FondazioneChipsIT/astral/README.md

# SCAR-V

**SCAR-V** (**S**uperscalar **C**FI **A**ccelerated **R**ISC **-V** Processor) is developed by Fondazione Chips-IT as a fully open-source framework that exploits the RoT to implement runtime-adaptable machine learning-based CFI enforcement in heterogeneous RISC-V SoCs.
SCAR-V integrates a zero-overhead Control-Transfer Record Unit in the application
core exposing the execution traces to a trace snooper; secure orchestration within the OpenTitan Root of Trust; low-latency AI-based CFI anomaly detection deployed on an 8-core cluster executing in a secure environment within the RoT perimeter.

SCAR-V is implemented on a reference architecture from [Pulp-Platform](https://github.com/pulp-platform) that features [OpenTitan](https://opentitan.org/) as embedded RoT and synthesized the system in Global Foundries 22 nm FD-SOI process.

For a detailed description of the CFI theory and architecture see: (TODO) add link to paper by M. Ciani et alt.

## Motivation

Modern embedded systems, such as IoT devices and safety-critical cyber-physical platforms deployed in the field,
are exposed to control-flow hijacking attacks, where techniques like Return-Oriented Programming and Jump-Oriented Programming can bypass safety checks and compromise system integrity. Control-Flow Integrity has long been recognized as a
security countermeasure. However, existing solutions either rely on pure-software mechanisms incurring high latency overheads, or hardware solutions which are either based on fixed hardware monitors that prevents runtime adapatbility, or on proprietary ISA extensions and compiling toolchains, limiting flexibility.
Moreover, most of existing solutions are not anchored to a hardware Root-of-Trust (RoT).

## Quick Start

* To learn how to build and use SCAR-V, see [Getting
  Started](https://fondazionechipsit.github.io/astral/gs/).
* To learn about available simulation, FPGA, and ASIC targets, see
  [Targets](https://fondazionechipsit.github.io/astral/tg).
* For detailed information on SCAR-V's inner workings, consult the [User
  Manual](https://fondazionechipsit.github.io/astral/um/).

If you are impatient and have all needed
[dependencies](https://fondazionechipsit.github.io/astral/gs/#dependencies), type:

```
source env/env-chips.sh
bender update
make car-all PYTHON=python3
make tech-init
```

and then run a [simulation](https://fondazionechipsit.github.io/astral/tg/sim) with Questasim by typing:

```tcl
make car-vsim-sim-build DEBUG=1 TECH_SIM=1
make car-vsim-sim-run CHS_BINARY=./sw/tests/bare-metal/hostd/helloworld.car.spm.elf DEBUG=1 TECH_SIM=1
```

---

To display the main *Make* build targets and their usage, from the root repository type:

```tcl
make help
```

The Make files are autodocumented.

### Technology

It is possible to initialize an available technology design flow by running `make tech-init` after cloning the repo.

## License

Unless specified otherwise in the respective file headers, all code checked into this repository is
made available under a permissive license. All hardware sources and tool scripts are licensed under
the Solderpad Hardware License 0.51 (see `LICENSE`) with the exception of generated register file
code (e.g. `hw/regs/*.sv`), which is generated by a fork of lowRISC's
[`regtool`](https://github.com/lowRISC/opentitan/blob/master/util/regtool.py) and licensed under
Apache 2.0. All software sources are licensed under Apache 2.0.
