FondazioneChipsIT/astral/docs/tg/synth.md

# Logic synthesis and physical implementation

Currently, synthesis of SCAAR-V is available with closed source tools, and hence its scripts are
added in the `nonfree` repository mentioned in the [Getting Started](../gs.md) section.

Once open-EDA and open-PDK flow is available, it will be updated in this page.
