FondazioneChipsIT/astral/sw/include/regs/soc_ctrl.h

// Generated register defines for carfield

// Copyright information found in source file:
// Copyright 2023 ETH Zurich and University of Bologna.

// Licensing information found in source file:
// 
// SPDX-License-Identifier: SHL-0.51

#ifndef _CARFIELD_REG_DEFS_
#define _CARFIELD_REG_DEFS_

#ifdef __cplusplus
extern "C" {
#endif
// Register width
#define CARFIELD_PARAM_REG_WIDTH 32

// Cheshire sha256 commit
#define CARFIELD_VERSION0_REG_OFFSET 0x0

// Safety Island sha256 commit
#define CARFIELD_VERSION1_REG_OFFSET 0x4

// Security Island sha256 commit
#define CARFIELD_VERSION2_REG_OFFSET 0x8

// PULP Cluster sha256 commit
#define CARFIELD_VERSION3_REG_OFFSET 0xc

// Spatz CLuster sha256 commit
#define CARFIELD_VERSION4_REG_OFFSET 0x10

// JEDEC ID CODE -TODO assign-
#define CARFIELD_JEDEC_IDCODE_REG_OFFSET 0x14

// Scratch
#define CARFIELD_GENERIC_SCRATCH0_REG_OFFSET 0x18

// Scratch
#define CARFIELD_GENERIC_SCRATCH1_REG_OFFSET 0x1c

// Host Domain reset -active high, inverted in HW-
#define CARFIELD_HOST_RST_REG_OFFSET 0x20
#define CARFIELD_HOST_RST_HOST_RST_BIT 0

// Periph Domain reset -active high, inverted in HW-
#define CARFIELD_PERIPH_RST_REG_OFFSET 0x24
#define CARFIELD_PERIPH_RST_PERIPH_RST_BIT 0

// Safety Island reset -active high, inverted in HW-
#define CARFIELD_SAFETY_ISLAND_RST_REG_OFFSET 0x28
#define CARFIELD_SAFETY_ISLAND_RST_SAFETY_ISLAND_RST_BIT 0

// Security Island reset -active high, inverted in HW-
#define CARFIELD_SECURITY_ISLAND_RST_REG_OFFSET 0x2c
#define CARFIELD_SECURITY_ISLAND_RST_SECURITY_ISLAND_RST_BIT 0

// PULP Cluster reset -active high, inverted in HW-
#define CARFIELD_PULP_CLUSTER_RST_REG_OFFSET 0x30
#define CARFIELD_PULP_CLUSTER_RST_PULP_CLUSTER_RST_BIT 0

// Spatz Cluster reset -active high, inverted in HW-
#define CARFIELD_SPATZ_CLUSTER_RST_REG_OFFSET 0x34
#define CARFIELD_SPATZ_CLUSTER_RST_SPATZ_CLUSTER_RST_BIT 0

// L2 reset -active high, inverted in HW-
#define CARFIELD_L2_RST_REG_OFFSET 0x38
#define CARFIELD_L2_RST_L2_RST_BIT 0

// Periph Domain  AXI isolate
#define CARFIELD_PERIPH_ISOLATE_REG_OFFSET 0x3c
#define CARFIELD_PERIPH_ISOLATE_PERIPH_ISOLATE_BIT 0

// Safety Island AXI isolate
#define CARFIELD_SAFETY_ISLAND_ISOLATE_REG_OFFSET 0x40
#define CARFIELD_SAFETY_ISLAND_ISOLATE_SAFETY_ISLAND_ISOLATE_BIT 0

// Security Island AXI isolate
#define CARFIELD_SECURITY_ISLAND_ISOLATE_REG_OFFSET 0x44
#define CARFIELD_SECURITY_ISLAND_ISOLATE_SECURITY_ISLAND_ISOLATE_BIT 0

// PULP Cluster AXI isolate
#define CARFIELD_PULP_CLUSTER_ISOLATE_REG_OFFSET 0x48
#define CARFIELD_PULP_CLUSTER_ISOLATE_PULP_CLUSTER_ISOLATE_BIT 0

// Spatz Cluster AXI isolate
#define CARFIELD_SPATZ_CLUSTER_ISOLATE_REG_OFFSET 0x4c
#define CARFIELD_SPATZ_CLUSTER_ISOLATE_SPATZ_CLUSTER_ISOLATE_BIT 0

// L2 AXI isolate
#define CARFIELD_L2_ISOLATE_REG_OFFSET 0x50
#define CARFIELD_L2_ISOLATE_L2_ISOLATE_BIT 0

// Periph Domain AXI isolate status
#define CARFIELD_PERIPH_ISOLATE_STATUS_REG_OFFSET 0x54
#define CARFIELD_PERIPH_ISOLATE_STATUS_PERIPH_ISOLATE_STATUS_BIT 0

// Safety Island AXI isolate status
#define CARFIELD_SAFETY_ISLAND_ISOLATE_STATUS_REG_OFFSET 0x58
#define CARFIELD_SAFETY_ISLAND_ISOLATE_STATUS_SAFETY_ISLAND_ISOLATE_STATUS_BIT 0

// Security Island AXI isolate status
#define CARFIELD_SECURITY_ISLAND_ISOLATE_STATUS_REG_OFFSET 0x5c
#define CARFIELD_SECURITY_ISLAND_ISOLATE_STATUS_SECURITY_ISLAND_ISOLATE_STATUS_BIT \
  0

// PULP Cluster AXI isolate status
#define CARFIELD_PULP_CLUSTER_ISOLATE_STATUS_REG_OFFSET 0x60
#define CARFIELD_PULP_CLUSTER_ISOLATE_STATUS_PULP_CLUSTER_ISOLATE_STATUS_BIT 0

// Spatz Cluster AXI isolate status
#define CARFIELD_SPATZ_CLUSTER_ISOLATE_STATUS_REG_OFFSET 0x64
#define CARFIELD_SPATZ_CLUSTER_ISOLATE_STATUS_SPATZ_CLUSTER_ISOLATE_STATUS_BIT 0

// L2 AXI isolate status
#define CARFIELD_L2_ISOLATE_STATUS_REG_OFFSET 0x68
#define CARFIELD_L2_ISOLATE_STATUS_L2_ISOLATE_STATUS_BIT 0

// Periph Domain clk gate enable
#define CARFIELD_PERIPH_CLK_EN_REG_OFFSET 0x6c
#define CARFIELD_PERIPH_CLK_EN_PERIPH_CLK_EN_BIT 0

// Safety Island clk gate enable
#define CARFIELD_SAFETY_ISLAND_CLK_EN_REG_OFFSET 0x70
#define CARFIELD_SAFETY_ISLAND_CLK_EN_SAFETY_ISLAND_CLK_EN_BIT 0

// Security Island clk gate enable
#define CARFIELD_SECURITY_ISLAND_CLK_EN_REG_OFFSET 0x74
#define CARFIELD_SECURITY_ISLAND_CLK_EN_SECURITY_ISLAND_CLK_EN_BIT 0

// PULP Cluster clk gate enable
#define CARFIELD_PULP_CLUSTER_CLK_EN_REG_OFFSET 0x78
#define CARFIELD_PULP_CLUSTER_CLK_EN_PULP_CLUSTER_CLK_EN_BIT 0

// Spatz Cluster clk gate enable
#define CARFIELD_SPATZ_CLUSTER_CLK_EN_REG_OFFSET 0x7c
#define CARFIELD_SPATZ_CLUSTER_CLK_EN_SPATZ_CLUSTER_CLK_EN_BIT 0

// Shared L2 memory clk gate enable
#define CARFIELD_L2_CLK_EN_REG_OFFSET 0x80
#define CARFIELD_L2_CLK_EN_L2_CLK_EN_BIT 0

// Periph Domain fll select (0 -> host fll, 1 -> alt fll, 2 -> per fll, 3 ->
// secd fll)
#define CARFIELD_PERIPH_CLK_SEL_REG_OFFSET 0x84
#define CARFIELD_PERIPH_CLK_SEL_PERIPH_CLK_SEL_MASK 0x3
#define CARFIELD_PERIPH_CLK_SEL_PERIPH_CLK_SEL_OFFSET 0
#define CARFIELD_PERIPH_CLK_SEL_PERIPH_CLK_SEL_FIELD \
  ((bitfield_field32_t) { .mask = CARFIELD_PERIPH_CLK_SEL_PERIPH_CLK_SEL_MASK, .index = CARFIELD_PERIPH_CLK_SEL_PERIPH_CLK_SEL_OFFSET })

// Safety Island fll select (0 -> host fll, 1 -> alt fll, 2 -> per fll, 3 ->
// secd fll)
#define CARFIELD_SAFETY_ISLAND_CLK_SEL_REG_OFFSET 0x88
#define CARFIELD_SAFETY_ISLAND_CLK_SEL_SAFETY_ISLAND_CLK_SEL_MASK 0x3
#define CARFIELD_SAFETY_ISLAND_CLK_SEL_SAFETY_ISLAND_CLK_SEL_OFFSET 0
#define CARFIELD_SAFETY_ISLAND_CLK_SEL_SAFETY_ISLAND_CLK_SEL_FIELD \
  ((bitfield_field32_t) { .mask = CARFIELD_SAFETY_ISLAND_CLK_SEL_SAFETY_ISLAND_CLK_SEL_MASK, .index = CARFIELD_SAFETY_ISLAND_CLK_SEL_SAFETY_ISLAND_CLK_SEL_OFFSET })

// Security Island fll select (0 -> host fll, 1 -> alt fll, 2 -> per fll, 3
// -> secd fll)
#define CARFIELD_SECURITY_ISLAND_CLK_SEL_REG_OFFSET 0x8c
#define CARFIELD_SECURITY_ISLAND_CLK_SEL_SECURITY_ISLAND_CLK_SEL_MASK 0x3
#define CARFIELD_SECURITY_ISLAND_CLK_SEL_SECURITY_ISLAND_CLK_SEL_OFFSET 0
#define CARFIELD_SECURITY_ISLAND_CLK_SEL_SECURITY_ISLAND_CLK_SEL_FIELD \
  ((bitfield_field32_t) { .mask = CARFIELD_SECURITY_ISLAND_CLK_SEL_SECURITY_ISLAND_CLK_SEL_MASK, .index = CARFIELD_SECURITY_ISLAND_CLK_SEL_SECURITY_ISLAND_CLK_SEL_OFFSET })

// PULP Cluster fll select (0 -> host fll, 1 -> alt fll, 2 -> per fll, 3 ->
// secd fll)
#define CARFIELD_PULP_CLUSTER_CLK_SEL_REG_OFFSET 0x90
#define CARFIELD_PULP_CLUSTER_CLK_SEL_PULP_CLUSTER_CLK_SEL_MASK 0x3
#define CARFIELD_PULP_CLUSTER_CLK_SEL_PULP_CLUSTER_CLK_SEL_OFFSET 0
#define CARFIELD_PULP_CLUSTER_CLK_SEL_PULP_CLUSTER_CLK_SEL_FIELD \
  ((bitfield_field32_t) { .mask = CARFIELD_PULP_CLUSTER_CLK_SEL_PULP_CLUSTER_CLK_SEL_MASK, .index = CARFIELD_PULP_CLUSTER_CLK_SEL_PULP_CLUSTER_CLK_SEL_OFFSET })

// Spatz Cluster fll select (0 -> host fll, 1 -> alt fll, 2 -> per fll, 3 ->
// secd fll)
#define CARFIELD_SPATZ_CLUSTER_CLK_SEL_REG_OFFSET 0x94
#define CARFIELD_SPATZ_CLUSTER_CLK_SEL_SPATZ_CLUSTER_CLK_SEL_MASK 0x3
#define CARFIELD_SPATZ_CLUSTER_CLK_SEL_SPATZ_CLUSTER_CLK_SEL_OFFSET 0
#define CARFIELD_SPATZ_CLUSTER_CLK_SEL_SPATZ_CLUSTER_CLK_SEL_FIELD \
  ((bitfield_field32_t) { .mask = CARFIELD_SPATZ_CLUSTER_CLK_SEL_SPATZ_CLUSTER_CLK_SEL_MASK, .index = CARFIELD_SPATZ_CLUSTER_CLK_SEL_SPATZ_CLUSTER_CLK_SEL_OFFSET })

// L2 Memory fll select (0 -> host fll, 1 -> alt fll, 2 -> per fll, 3 -> secd
// fll)
#define CARFIELD_L2_CLK_SEL_REG_OFFSET 0x98
#define CARFIELD_L2_CLK_SEL_L2_CLK_SEL_MASK 0x3
#define CARFIELD_L2_CLK_SEL_L2_CLK_SEL_OFFSET 0
#define CARFIELD_L2_CLK_SEL_L2_CLK_SEL_FIELD \
  ((bitfield_field32_t) { .mask = CARFIELD_L2_CLK_SEL_L2_CLK_SEL_MASK, .index = CARFIELD_L2_CLK_SEL_L2_CLK_SEL_OFFSET })

// Periph Domain clk divider value
#define CARFIELD_PERIPH_CLK_DIV_VALUE_REG_OFFSET 0x9c
#define CARFIELD_PERIPH_CLK_DIV_VALUE_PERIPH_CLK_DIV_VALUE_MASK 0xffffff
#define CARFIELD_PERIPH_CLK_DIV_VALUE_PERIPH_CLK_DIV_VALUE_OFFSET 0
#define CARFIELD_PERIPH_CLK_DIV_VALUE_PERIPH_CLK_DIV_VALUE_FIELD \
  ((bitfield_field32_t) { .mask = CARFIELD_PERIPH_CLK_DIV_VALUE_PERIPH_CLK_DIV_VALUE_MASK, .index = CARFIELD_PERIPH_CLK_DIV_VALUE_PERIPH_CLK_DIV_VALUE_OFFSET })

// Safety Island clk divider value
#define CARFIELD_SAFETY_ISLAND_CLK_DIV_VALUE_REG_OFFSET 0xa0
#define CARFIELD_SAFETY_ISLAND_CLK_DIV_VALUE_SAFETY_ISLAND_CLK_DIV_VALUE_MASK \
  0xffffff
#define CARFIELD_SAFETY_ISLAND_CLK_DIV_VALUE_SAFETY_ISLAND_CLK_DIV_VALUE_OFFSET \
  0
#define CARFIELD_SAFETY_ISLAND_CLK_DIV_VALUE_SAFETY_ISLAND_CLK_DIV_VALUE_FIELD \
  ((bitfield_field32_t) { .mask = CARFIELD_SAFETY_ISLAND_CLK_DIV_VALUE_SAFETY_ISLAND_CLK_DIV_VALUE_MASK, .index = CARFIELD_SAFETY_ISLAND_CLK_DIV_VALUE_SAFETY_ISLAND_CLK_DIV_VALUE_OFFSET })

// Security Island clk divider value
#define CARFIELD_SECURITY_ISLAND_CLK_DIV_VALUE_REG_OFFSET 0xa4
#define CARFIELD_SECURITY_ISLAND_CLK_DIV_VALUE_SECURITY_ISLAND_CLK_DIV_VALUE_MASK \
  0xffffff
#define CARFIELD_SECURITY_ISLAND_CLK_DIV_VALUE_SECURITY_ISLAND_CLK_DIV_VALUE_OFFSET \
  0
#define CARFIELD_SECURITY_ISLAND_CLK_DIV_VALUE_SECURITY_ISLAND_CLK_DIV_VALUE_FIELD \
  ((bitfield_field32_t) { .mask = CARFIELD_SECURITY_ISLAND_CLK_DIV_VALUE_SECURITY_ISLAND_CLK_DIV_VALUE_MASK, .index = CARFIELD_SECURITY_ISLAND_CLK_DIV_VALUE_SECURITY_ISLAND_CLK_DIV_VALUE_OFFSET })

// PULP Cluster clk divider value
#define CARFIELD_PULP_CLUSTER_CLK_DIV_VALUE_REG_OFFSET 0xa8
#define CARFIELD_PULP_CLUSTER_CLK_DIV_VALUE_PULP_CLUSTER_CLK_DIV_VALUE_MASK \
  0xffffff
#define CARFIELD_PULP_CLUSTER_CLK_DIV_VALUE_PULP_CLUSTER_CLK_DIV_VALUE_OFFSET 0
#define CARFIELD_PULP_CLUSTER_CLK_DIV_VALUE_PULP_CLUSTER_CLK_DIV_VALUE_FIELD \
  ((bitfield_field32_t) { .mask = CARFIELD_PULP_CLUSTER_CLK_DIV_VALUE_PULP_CLUSTER_CLK_DIV_VALUE_MASK, .index = CARFIELD_PULP_CLUSTER_CLK_DIV_VALUE_PULP_CLUSTER_CLK_DIV_VALUE_OFFSET })

// Spatz Cluster clk divider value
#define CARFIELD_SPATZ_CLUSTER_CLK_DIV_VALUE_REG_OFFSET 0xac
#define CARFIELD_SPATZ_CLUSTER_CLK_DIV_VALUE_SPATZ_CLUSTER_CLK_DIV_VALUE_MASK \
  0xffffff
#define CARFIELD_SPATZ_CLUSTER_CLK_DIV_VALUE_SPATZ_CLUSTER_CLK_DIV_VALUE_OFFSET \
  0
#define CARFIELD_SPATZ_CLUSTER_CLK_DIV_VALUE_SPATZ_CLUSTER_CLK_DIV_VALUE_FIELD \
  ((bitfield_field32_t) { .mask = CARFIELD_SPATZ_CLUSTER_CLK_DIV_VALUE_SPATZ_CLUSTER_CLK_DIV_VALUE_MASK, .index = CARFIELD_SPATZ_CLUSTER_CLK_DIV_VALUE_SPATZ_CLUSTER_CLK_DIV_VALUE_OFFSET })

// L2 Memory clk divider value
#define CARFIELD_L2_CLK_DIV_VALUE_REG_OFFSET 0xb0
#define CARFIELD_L2_CLK_DIV_VALUE_L2_CLK_DIV_VALUE_MASK 0xffffff
#define CARFIELD_L2_CLK_DIV_VALUE_L2_CLK_DIV_VALUE_OFFSET 0
#define CARFIELD_L2_CLK_DIV_VALUE_L2_CLK_DIV_VALUE_FIELD \
  ((bitfield_field32_t) { .mask = CARFIELD_L2_CLK_DIV_VALUE_L2_CLK_DIV_VALUE_MASK, .index = CARFIELD_L2_CLK_DIV_VALUE_L2_CLK_DIV_VALUE_OFFSET })

// Host Domain fetch enable
#define CARFIELD_HOST_FETCH_ENABLE_REG_OFFSET 0xb4
#define CARFIELD_HOST_FETCH_ENABLE_HOST_FETCH_ENABLE_BIT 0

// Safety Island fetch enable
#define CARFIELD_SAFETY_ISLAND_FETCH_ENABLE_REG_OFFSET 0xb8
#define CARFIELD_SAFETY_ISLAND_FETCH_ENABLE_SAFETY_ISLAND_FETCH_ENABLE_BIT 0

// Security Island fetch enable
#define CARFIELD_SECURITY_ISLAND_FETCH_ENABLE_REG_OFFSET 0xbc
#define CARFIELD_SECURITY_ISLAND_FETCH_ENABLE_SECURITY_ISLAND_FETCH_ENABLE_BIT 0

// PULP Cluster fetch enable
#define CARFIELD_PULP_CLUSTER_FETCH_ENABLE_REG_OFFSET 0xc0
#define CARFIELD_PULP_CLUSTER_FETCH_ENABLE_PULP_CLUSTER_FETCH_ENABLE_BIT 0

// Spatz Cluster debug req
#define CARFIELD_SPATZ_CLUSTER_DEBUG_REQ_REG_OFFSET 0xc4
#define CARFIELD_SPATZ_CLUSTER_DEBUG_REQ_SPATZ_CLUSTER_DEBUG_REQ_MASK 0x3
#define CARFIELD_SPATZ_CLUSTER_DEBUG_REQ_SPATZ_CLUSTER_DEBUG_REQ_OFFSET 0
#define CARFIELD_SPATZ_CLUSTER_DEBUG_REQ_SPATZ_CLUSTER_DEBUG_REQ_FIELD \
  ((bitfield_field32_t) { .mask = CARFIELD_SPATZ_CLUSTER_DEBUG_REQ_SPATZ_CLUSTER_DEBUG_REQ_MASK, .index = CARFIELD_SPATZ_CLUSTER_DEBUG_REQ_SPATZ_CLUSTER_DEBUG_REQ_OFFSET })

// Host boot address
#define CARFIELD_HOST_BOOT_ADDR_REG_OFFSET 0xc8

// Safety Island boot address
#define CARFIELD_SAFETY_ISLAND_BOOT_ADDR_REG_OFFSET 0xcc

// Security Island boot address
#define CARFIELD_SECURITY_ISLAND_BOOT_ADDR_REG_OFFSET 0xd0

// PULP Cluster boot address
#define CARFIELD_PULP_CLUSTER_BOOT_ADDR_REG_OFFSET 0xd4

// Spatz Cluster boot address
#define CARFIELD_SPATZ_CLUSTER_BOOT_ADDR_REG_OFFSET 0xd8

// PULP Cluster boot enable
#define CARFIELD_PULP_CLUSTER_BOOT_ENABLE_REG_OFFSET 0xdc
#define CARFIELD_PULP_CLUSTER_BOOT_ENABLE_PULP_CLUSTER_BOOT_ENABLE_BIT 0

// Spatz Cluster busy
#define CARFIELD_SPATZ_CLUSTER_BUSY_REG_OFFSET 0xe0
#define CARFIELD_SPATZ_CLUSTER_BUSY_SPATZ_CLUSTER_BUSY_BIT 0

// PULP Cluster busy
#define CARFIELD_PULP_CLUSTER_BUSY_REG_OFFSET 0xe4
#define CARFIELD_PULP_CLUSTER_BUSY_PULP_CLUSTER_BUSY_BIT 0

// PULP Cluster end of computation
#define CARFIELD_PULP_CLUSTER_EOC_REG_OFFSET 0xe8
#define CARFIELD_PULP_CLUSTER_EOC_PULP_CLUSTER_EOC_BIT 0

// Ethernet clock divider enable bit
#define CARFIELD_ETH_CLK_DIV_EN_REG_OFFSET 0xec
#define CARFIELD_ETH_CLK_DIV_EN_ETH_CLK_DIV_EN_BIT 0

// Ethernet clock divider value
#define CARFIELD_ETH_CLK_DIV_VALUE_REG_OFFSET 0xf0
#define CARFIELD_ETH_CLK_DIV_VALUE_ETH_CLK_DIV_VALUE_MASK 0xfffff
#define CARFIELD_ETH_CLK_DIV_VALUE_ETH_CLK_DIV_VALUE_OFFSET 0
#define CARFIELD_ETH_CLK_DIV_VALUE_ETH_CLK_DIV_VALUE_FIELD \
  ((bitfield_field32_t) { .mask = CARFIELD_ETH_CLK_DIV_VALUE_ETH_CLK_DIV_VALUE_MASK, .index = CARFIELD_ETH_CLK_DIV_VALUE_ETH_CLK_DIV_VALUE_OFFSET })

// Hyperbus clock divider enable bit
#define CARFIELD_HYPERBUS_CLK_DIV_EN_REG_OFFSET 0xf4
#define CARFIELD_HYPERBUS_CLK_DIV_EN_HYPERBUS_CLK_DIV_EN_BIT 0

// Hyperbus clock divider value
#define CARFIELD_HYPERBUS_CLK_DIV_VALUE_REG_OFFSET 0xf8
#define CARFIELD_HYPERBUS_CLK_DIV_VALUE_HYPERBUS_CLK_DIV_VALUE_MASK 0xfffff
#define CARFIELD_HYPERBUS_CLK_DIV_VALUE_HYPERBUS_CLK_DIV_VALUE_OFFSET 0
#define CARFIELD_HYPERBUS_CLK_DIV_VALUE_HYPERBUS_CLK_DIV_VALUE_FIELD \
  ((bitfield_field32_t) { .mask = CARFIELD_HYPERBUS_CLK_DIV_VALUE_HYPERBUS_CLK_DIV_VALUE_MASK, .index = CARFIELD_HYPERBUS_CLK_DIV_VALUE_HYPERBUS_CLK_DIV_VALUE_OFFSET })

// FLL lock status
#define CARFIELD_FLL_LOCK_REG_OFFSET 0xfc
#define CARFIELD_FLL_LOCK_FLL_LOCK_MASK 0x1f
#define CARFIELD_FLL_LOCK_FLL_LOCK_OFFSET 0
#define CARFIELD_FLL_LOCK_FLL_LOCK_FIELD \
  ((bitfield_field32_t) { .mask = CARFIELD_FLL_LOCK_FLL_LOCK_MASK, .index = CARFIELD_FLL_LOCK_FLL_LOCK_OFFSET })

// Host domain debug clock divider (default active)
#define CARFIELD_HOST_DEBUG_CLK_EN_REG_OFFSET 0x100
#define CARFIELD_HOST_DEBUG_CLK_EN_HOST_DEBUG_CLK_EN_BIT 0

// L2 domain debug clock divider (default active)
#define CARFIELD_L2_DEBUG_CLK_EN_REG_OFFSET 0x104
#define CARFIELD_L2_DEBUG_CLK_EN_L2_DEBUG_CLK_EN_BIT 0

// Safe domain debug clock divider (default active)
#define CARFIELD_SAFED_DEBUG_CLK_EN_REG_OFFSET 0x108
#define CARFIELD_SAFED_DEBUG_CLK_EN_SAFED_DEBUG_CLK_EN_BIT 0

// PULP domain debug clock divider (default active)
#define CARFIELD_PULPD_DEBUG_CLK_EN_REG_OFFSET 0x10c
#define CARFIELD_PULPD_DEBUG_CLK_EN_PULPD_DEBUG_CLK_EN_BIT 0

// Spatz domain debug clock divider (default active)
#define CARFIELD_SPATZD_DEBUG_CLK_EN_REG_OFFSET 0x110
#define CARFIELD_SPATZD_DEBUG_CLK_EN_SPATZD_DEBUG_CLK_EN_BIT 0

// Secure domain debug clock divider (default active)
#define CARFIELD_SECURED_DEBUG_CLK_EN_REG_OFFSET 0x114
#define CARFIELD_SECURED_DEBUG_CLK_EN_SECURED_DEBUG_CLK_EN_BIT 0

// Peripheral domain debug clock divider (default active)
#define CARFIELD_PERIPH_DEBUG_CLK_EN_REG_OFFSET 0x118
#define CARFIELD_PERIPH_DEBUG_CLK_EN_PERIPH_DEBUG_CLK_EN_BIT 0

// Host Domain debug clk divider value
#define CARFIELD_HOST_DEBUG_CLK_DIV_VALUE_REG_OFFSET 0x11c
#define CARFIELD_HOST_DEBUG_CLK_DIV_VALUE_HOST_DEBUG_CLK_DIV_VALUE_MASK 0xffffff
#define CARFIELD_HOST_DEBUG_CLK_DIV_VALUE_HOST_DEBUG_CLK_DIV_VALUE_OFFSET 0
#define CARFIELD_HOST_DEBUG_CLK_DIV_VALUE_HOST_DEBUG_CLK_DIV_VALUE_FIELD \
  ((bitfield_field32_t) { .mask = CARFIELD_HOST_DEBUG_CLK_DIV_VALUE_HOST_DEBUG_CLK_DIV_VALUE_MASK, .index = CARFIELD_HOST_DEBUG_CLK_DIV_VALUE_HOST_DEBUG_CLK_DIV_VALUE_OFFSET })

// L2 domain debug clk divider value
#define CARFIELD_L2_DEBUG_CLK_DIV_VALUE_REG_OFFSET 0x120
#define CARFIELD_L2_DEBUG_CLK_DIV_VALUE_L2_DEBUG_CLK_DIV_VALUE_MASK 0xffffff
#define CARFIELD_L2_DEBUG_CLK_DIV_VALUE_L2_DEBUG_CLK_DIV_VALUE_OFFSET 0
#define CARFIELD_L2_DEBUG_CLK_DIV_VALUE_L2_DEBUG_CLK_DIV_VALUE_FIELD \
  ((bitfield_field32_t) { .mask = CARFIELD_L2_DEBUG_CLK_DIV_VALUE_L2_DEBUG_CLK_DIV_VALUE_MASK, .index = CARFIELD_L2_DEBUG_CLK_DIV_VALUE_L2_DEBUG_CLK_DIV_VALUE_OFFSET })

// Safe Domain debug clk divider value
#define CARFIELD_SAFED_DEBUG_CLK_DIV_VALUE_REG_OFFSET 0x124
#define CARFIELD_SAFED_DEBUG_CLK_DIV_VALUE_SAFED_DEBUG_CLK_DIV_VALUE_MASK \
  0xffffff
#define CARFIELD_SAFED_DEBUG_CLK_DIV_VALUE_SAFED_DEBUG_CLK_DIV_VALUE_OFFSET 0
#define CARFIELD_SAFED_DEBUG_CLK_DIV_VALUE_SAFED_DEBUG_CLK_DIV_VALUE_FIELD \
  ((bitfield_field32_t) { .mask = CARFIELD_SAFED_DEBUG_CLK_DIV_VALUE_SAFED_DEBUG_CLK_DIV_VALUE_MASK, .index = CARFIELD_SAFED_DEBUG_CLK_DIV_VALUE_SAFED_DEBUG_CLK_DIV_VALUE_OFFSET })

// PULP Domain debug clk divider value
#define CARFIELD_PULPD_DEBUG_CLK_DIV_VALUE_REG_OFFSET 0x128
#define CARFIELD_PULPD_DEBUG_CLK_DIV_VALUE_PULPD_DEBUG_CLK_DIV_VALUE_MASK \
  0xffffff
#define CARFIELD_PULPD_DEBUG_CLK_DIV_VALUE_PULPD_DEBUG_CLK_DIV_VALUE_OFFSET 0
#define CARFIELD_PULPD_DEBUG_CLK_DIV_VALUE_PULPD_DEBUG_CLK_DIV_VALUE_FIELD \
  ((bitfield_field32_t) { .mask = CARFIELD_PULPD_DEBUG_CLK_DIV_VALUE_PULPD_DEBUG_CLK_DIV_VALUE_MASK, .index = CARFIELD_PULPD_DEBUG_CLK_DIV_VALUE_PULPD_DEBUG_CLK_DIV_VALUE_OFFSET })

// Spatz Domain debug clk divider value
#define CARFIELD_SPATZD_DEBUG_CLK_DIV_VALUE_REG_OFFSET 0x12c
#define CARFIELD_SPATZD_DEBUG_CLK_DIV_VALUE_SPATZD_DEBUG_CLK_DIV_VALUE_MASK \
  0xffffff
#define CARFIELD_SPATZD_DEBUG_CLK_DIV_VALUE_SPATZD_DEBUG_CLK_DIV_VALUE_OFFSET 0
#define CARFIELD_SPATZD_DEBUG_CLK_DIV_VALUE_SPATZD_DEBUG_CLK_DIV_VALUE_FIELD \
  ((bitfield_field32_t) { .mask = CARFIELD_SPATZD_DEBUG_CLK_DIV_VALUE_SPATZD_DEBUG_CLK_DIV_VALUE_MASK, .index = CARFIELD_SPATZD_DEBUG_CLK_DIV_VALUE_SPATZD_DEBUG_CLK_DIV_VALUE_OFFSET })

// Secure Domain debug clk divider value
#define CARFIELD_SECURED_DEBUG_CLK_DIV_VALUE_REG_OFFSET 0x130
#define CARFIELD_SECURED_DEBUG_CLK_DIV_VALUE_SECURED_DEBUG_CLK_DIV_VALUE_MASK \
  0xffffff
#define CARFIELD_SECURED_DEBUG_CLK_DIV_VALUE_SECURED_DEBUG_CLK_DIV_VALUE_OFFSET \
  0
#define CARFIELD_SECURED_DEBUG_CLK_DIV_VALUE_SECURED_DEBUG_CLK_DIV_VALUE_FIELD \
  ((bitfield_field32_t) { .mask = CARFIELD_SECURED_DEBUG_CLK_DIV_VALUE_SECURED_DEBUG_CLK_DIV_VALUE_MASK, .index = CARFIELD_SECURED_DEBUG_CLK_DIV_VALUE_SECURED_DEBUG_CLK_DIV_VALUE_OFFSET })

// Peripheral Domain debug clk divider value
#define CARFIELD_PERIPH_DEBUG_CLK_DIV_VALUE_REG_OFFSET 0x134
#define CARFIELD_PERIPH_DEBUG_CLK_DIV_VALUE_PERIPH_DEBUG_CLK_DIV_VALUE_MASK \
  0xffffff
#define CARFIELD_PERIPH_DEBUG_CLK_DIV_VALUE_PERIPH_DEBUG_CLK_DIV_VALUE_OFFSET 0
#define CARFIELD_PERIPH_DEBUG_CLK_DIV_VALUE_PERIPH_DEBUG_CLK_DIV_VALUE_FIELD \
  ((bitfield_field32_t) { .mask = CARFIELD_PERIPH_DEBUG_CLK_DIV_VALUE_PERIPH_DEBUG_CLK_DIV_VALUE_MASK, .index = CARFIELD_PERIPH_DEBUG_CLK_DIV_VALUE_PERIPH_DEBUG_CLK_DIV_VALUE_OFFSET })

#ifdef __cplusplus
}  // extern "C"
#endif
#endif  // _CARFIELD_REG_DEFS_
// End generated register defines for carfield
