FondazioneChipsIT/astral/hw/astral_wrap.sv

// Copyright 2023 ETH Zurich and University of Bologna.
// Solderpad Hardware License, Version 0.51, see LICENSE for details.
// SPDX-License-Identifier: SHL-0.51
//
// Victor Isachi <victor.isachi@unibo.it>

`include "cheshire/typedef.svh"
`include "axi/typedef.svh"
`include "apb/typedef.svh"

module astral_wrap
  import carfield_pkg::*;
  import carfield_chip_pkg::*;
  import carfield_reg_pkg::*;
  import cheshire_pkg::*;
  import top_padframe_pkg::*;
#(
  parameter cheshire_cfg_t Cfg = carfield_pkg::CarfieldCfgDefault
) (
  inout wire logic pad_botl_ot_boot_mode_pad,
  inout wire logic pad_botl_jtag_ot_tclk_pad,
  inout wire logic pad_botl_jtag_ot_trst_n_pad,
  inout wire logic pad_botl_jtag_ot_tms_pad,
  inout wire logic pad_botl_jtag_ot_tdi_pad,
  inout wire logic pad_botl_jtag_ot_tdo_pad,
  inout wire logic pad_botl_ot_uart_tx_pad,
  inout wire logic pad_botl_ot_uart_rx_pad,
  inout wire logic pad_botl_spih_sck_pad,
  inout wire logic pad_botl_spih_csb_pad,
  inout wire logic pad_botl_spih_sd_0_pad,
  inout wire logic pad_botl_spih_sd_1_pad,
  inout wire logic pad_botl_spih_sd_2_pad,
  inout wire logic pad_botl_spih_sd_3_pad,
  inout wire logic pad_botl_gpio_2_pad,
  inout wire logic pad_botl_gpio_3_pad,
  inout wire logic pad_botl_spih_ot_sd_1_pad,
  inout wire logic pad_botl_spih_ot_sd_2_pad,
  inout wire logic pad_botl_spih_ot_sd_3_pad,
  inout wire logic pad_botl_ref_clk_pad,
  inout wire logic pad_botl_fll_host_pad,
  inout wire logic pad_botl_fll_secd_pad,
  inout wire logic pad_botl_fll_bypass_pad,
  inout wire logic pad_botl_pwr_on_rst_n_pad,
  inout wire logic pad_botl_boot_mode_0_pad,
  inout wire logic pad_botl_boot_mode_1_pad,
  inout wire logic pad_botl_secure_boot_pad,
  inout wire logic pad_botl_jtag_tclk_pad,
  inout wire logic pad_botl_jtag_trst_n_pad,
  inout wire logic pad_botl_jtag_tms_pad,
  inout wire logic pad_botl_jtag_tdi_pad,
  inout wire logic pad_botl_jtag_tdo_pad,
  inout wire logic pad_botl_uart_tx_pad,
  inout wire logic pad_botl_uart_rx_pad,
  inout wire logic pad_botl_gpio_0_pad,
  inout wire logic pad_botl_gpio_1_pad,
  inout wire logic pad_botl_spih_ot_sck_pad,
  inout wire logic pad_botl_spih_ot_csb_pad,
  inout wire logic pad_botl_spih_ot_sd_0_pad,
  inout wire logic pad_hyper_phy0_cs_n_0_pad,
  inout wire logic pad_hyper_phy0_cs_n_1_pad,
  inout wire logic pad_hyper_phy0_ck_pad,
  inout wire logic pad_hyper_phy0_ck_n_pad,
  inout wire logic pad_hyper_phy0_rwds_pad,
  inout wire logic pad_hyper_phy0_dq_b0_pad,
  inout wire logic pad_hyper_phy0_dq_b1_pad,
  inout wire logic pad_hyper_phy0_dq_b2_pad,
  inout wire logic pad_hyper_phy0_dq_b3_pad,
  inout wire logic pad_hyper_phy0_dq_b4_pad,
  inout wire logic pad_hyper_phy0_dq_b5_pad,
  inout wire logic pad_hyper_phy0_dq_b6_pad,
  inout wire logic pad_hyper_phy0_dq_b7_pad,
  inout wire logic pad_hyper_phy0_reset_n_pad,
  inout wire logic pad_hyper_phy1_cs_n_0_pad,
  inout wire logic pad_hyper_phy1_cs_n_1_pad,
  inout wire logic pad_hyper_phy1_ck_pad,
  inout wire logic pad_hyper_phy1_ck_n_pad,
  inout wire logic pad_hyper_phy1_rwds_pad,
  inout wire logic pad_hyper_phy1_dq_b0_pad,
  inout wire logic pad_hyper_phy1_dq_b1_pad,
  inout wire logic pad_hyper_phy1_dq_b2_pad,
  inout wire logic pad_hyper_phy1_dq_b3_pad,
  inout wire logic pad_hyper_phy1_dq_b4_pad,
  inout wire logic pad_hyper_phy1_dq_b5_pad,
  inout wire logic pad_hyper_phy1_dq_b6_pad,
  inout wire logic pad_hyper_phy1_dq_b7_pad,
  inout wire logic pad_hyper_phy1_reset_n_pad
);

  ////////////////////////////
  // Carfield configuration //
  ////////////////////////////

  localparam cheshire_cfg_t CarfieldCfg = carfield_pkg::CarfieldCfgDefault;
  `CHESHIRE_TYPEDEF_ALL(carfield_, CarfieldCfg)


  ////////////////////////
  // Connection Signals //
  ////////////////////////

  // POR
  logic pwr_on_rst_n;
  logic ref_clk_pwr_on_rst_n;

  // clock signals
  logic ref_clk;

  // secure boot mode signal
  logic secure_boot;

  // Debug signals
  carfield_pkg::carfield_debug_sigs_t debug_signals;

  //////////////
  // Padframe //
  //////////////

  // register interface
  // to padframe: ref clock domain
  carfield_reg_req_t padframe_refclk_cfg_reg_req;
  carfield_reg_rsp_t padframe_refclk_cfg_reg_rsp;

  // signal to pad
  top_padframe_signals_pad2soc_t st_pad2soc_signals;
  top_padframe_signals_soc2pad_t st_soc2pad_signals;

  // pad2soc
  // is secure boot enabled
  assign secure_boot = st_pad2soc_signals.secure_boot_i;
  // safed bootmodes - no sefety island
  logic [1:0] bootmode_safe_isln_s;
  assign bootmode_safe_isln_s[0] = 1'b0;
  assign bootmode_safe_isln_s[1] = 1'b0;
  // secd bootmodes
  logic [1:0] bootmode_sec_isln_s;
  assign bootmode_sec_isln_s[0] = st_pad2soc_signals.ot_boot_mode_i;
  assign bootmode_sec_isln_s[1] = 1'b0;
  // hostd bootmodes
  logic [1:0] bootmode_host_s;
  assign bootmode_host_s[0] = st_pad2soc_signals.boot_mode_i_0;
  assign bootmode_host_s[1] = st_pad2soc_signals.boot_mode_i_1;
  // serial link
  logic [SlinkNumChan-1:0][SlinkNumLanes-1:0] serial_link_data_in_s; //left unconnected
  assign serial_link_data_in_s[0][0] = '0;
  assign serial_link_data_in_s[0][1] = '0;
  assign serial_link_data_in_s[0][2] = '0;
  assign serial_link_data_in_s[0][3] = '0;
  assign serial_link_data_in_s[0][4] = '0;
  assign serial_link_data_in_s[0][5] = '0;
  assign serial_link_data_in_s[0][6] = '0;
  assign serial_link_data_in_s[0][7] = '0;

  // pad2soc
  // spih
  logic [ 3:0] spih_sd_i_s;
  assign spih_sd_i_s[0] = st_pad2soc_signals.spih_sd_i_0;
  assign spih_sd_i_s[1] = st_pad2soc_signals.spih_sd_i_1;
  assign spih_sd_i_s[2] = st_pad2soc_signals.spih_sd_i_2;
  assign spih_sd_i_s[3] = st_pad2soc_signals.spih_sd_i_3;
  // spih_ot
  logic [ 3:0] spih_ot_sd_i_s;
  assign spih_ot_sd_i_s[0] = st_pad2soc_signals.spih_ot_sd_i_0;
  assign spih_ot_sd_i_s[1] = st_pad2soc_signals.spih_ot_sd_i_1;
  assign spih_ot_sd_i_s[2] = st_pad2soc_signals.spih_ot_sd_i_2;
  assign spih_ot_sd_i_s[3] = st_pad2soc_signals.spih_ot_sd_i_3;
  // ethernet
  logic [3:0] eth_rxd_i_s;
  assign eth_rxd_i_s[0] = '0;
  assign eth_rxd_i_s[1] = '0;
  assign eth_rxd_i_s[2] = '0;
  assign eth_rxd_i_s[3] = '0;

  // gpio
  logic [31:0] gpio_out_s;
  logic [31:0] gpio_tx_en_s;
  logic [31:0] gpio_in_s;
  assign st_soc2pad_signals.gpio_v_o_0  = gpio_out_s[0];
  assign st_soc2pad_signals.gpio_v_o_1  = gpio_out_s[1];
  assign st_soc2pad_signals.gpio_v_o_2  = gpio_out_s[2];
  assign st_soc2pad_signals.gpio_v_o_3  = gpio_out_s[3];
  // GPIO 4-31 remain unconnected
  assign st_soc2pad_signals.gpio_v_oen_i_0  = gpio_tx_en_s[0];
  assign st_soc2pad_signals.gpio_v_oen_i_1  = gpio_tx_en_s[1];
  assign st_soc2pad_signals.gpio_v_oen_i_2  = gpio_tx_en_s[2];
  assign st_soc2pad_signals.gpio_v_oen_i_3  = gpio_tx_en_s[3];
  // GPIO 4-31 remain unconnected
  assign gpio_in_s[0]  = st_pad2soc_signals.gpio_v_i_0;
  assign gpio_in_s[1]  = st_pad2soc_signals.gpio_v_i_1;
  assign gpio_in_s[2]  = st_pad2soc_signals.gpio_v_i_2;
  assign gpio_in_s[3]  = st_pad2soc_signals.gpio_v_i_3;
  // GPI0 4-31 remain unconnected
  assign gpio_in_s[31:4] = '0;

  // soc2pad
  // uart-- carfield itf
  // spi
  logic       spih_sck_o_s;
  logic [1:0] spih_csb_o_s;
  logic [3:0] spih_sd_o_s;
  logic [3:0] spih_sd_en_o_s;
  // TODO: CHECK POLARITY OF THE SIGNAL (SPI CS)
  assign st_soc2pad_signals.spih_csb_o_1    = spih_csb_o_s[1];
  assign st_soc2pad_signals.spih_sck_o      = spih_sck_o_s;
  assign st_soc2pad_signals.spih_sd_o_0     = spih_sd_o_s[0];
  assign st_soc2pad_signals.spih_sd_o_1     = spih_sd_o_s[1];
  assign st_soc2pad_signals.spih_sd_o_2     = spih_sd_o_s[2];
  assign st_soc2pad_signals.spih_sd_o_3     = spih_sd_o_s[3];
  assign st_soc2pad_signals.spih_sd_oen_i_0 = spih_sd_en_o_s[0];
  assign st_soc2pad_signals.spih_sd_oen_i_1 = spih_sd_en_o_s[1];
  assign st_soc2pad_signals.spih_sd_oen_i_2 = spih_sd_en_o_s[2];
  assign st_soc2pad_signals.spih_sd_oen_i_3 = spih_sd_en_o_s[3];
  // i2c -- carfield itf
  // spi_ot
  logic       spih_ot_sck_o_s;
  logic       spih_ot_csb_o_s;
  logic [3:0] spih_ot_sd_o_s;
  logic [3:0] spih_ot_sd_en_o_s;
  // TODO: CHECK POLARITY OF THE SIGNAL (SPI CS)
  assign st_soc2pad_signals.spih_ot_csb_o      = spih_ot_csb_o_s;
  assign st_soc2pad_signals.spih_ot_sck_o      = spih_ot_sck_o_s;
  assign st_soc2pad_signals.spih_ot_sd_o_0     = spih_ot_sd_o_s[0];
  assign st_soc2pad_signals.spih_ot_sd_o_1     = spih_ot_sd_o_s[1];
  assign st_soc2pad_signals.spih_ot_sd_o_2     = spih_ot_sd_o_s[2];
  assign st_soc2pad_signals.spih_ot_sd_o_3     = spih_ot_sd_o_s[3];
  assign st_soc2pad_signals.spih_ot_sd_oen_i_0 = spih_ot_sd_en_o_s[0];
  assign st_soc2pad_signals.spih_ot_sd_oen_i_1 = spih_ot_sd_en_o_s[1];
  assign st_soc2pad_signals.spih_ot_sd_oen_i_2 = spih_ot_sd_en_o_s[2];
  assign st_soc2pad_signals.spih_ot_sd_oen_i_3 = spih_ot_sd_en_o_s[3];
  // can0 -- carfield itf

  // External async register interface
  logic[1:0]              ext_reg_async_slv_req_src_out;
  logic[1:0]              ext_reg_async_slv_ack_src_in;
  carfield_reg_req_t[1:0] ext_reg_async_slv_data_src_out;
  logic[1:0]              ext_reg_async_slv_req_src_in;
  logic[1:0]              ext_reg_async_slv_ack_src_out;
  carfield_reg_rsp_t[1:0] ext_reg_async_slv_data_src_in;

  //////////////////////
  // Clock generation //
  //////////////////////
  logic[carfield_pkg::NumFll-1:0] clk_fll_out;
  logic[carfield_pkg::NumFll-1:0] clk_fll_e;
  logic[carfield_pkg::NumFll-1:0] fll_lock;
  logic[carfield_pkg::NumFll-1:0] fll_pwd;
  logic[carfield_pkg::NumFll-1:0] fll_ret;
  logic[carfield_pkg::NumFll-1:0] fll_test_mode;
  logic[carfield_pkg::NumFll-1:0] fll_scan_e;
  logic[carfield_pkg::NumFll-1:0] fll_scan_in;
  logic[carfield_pkg::NumFll-1:0] fll_scan_out;
  logic[carfield_pkg::NumFll-1:0] fll_scan_jtag_in;
  logic[carfield_pkg::NumFll-1:0] fll_scan_jtag_out;
  logic[carfield_pkg::NumFll-1:0] domain_clk;

  // ref_clk
  assign ref_clk      = st_pad2soc_signals.ref_clk_i;
  // power on reset
  assign pwr_on_rst_n = st_pad2soc_signals.pwr_on_rst_ni;

  assign clk_fll_e   = '{default: 1'b1};

  clk_int_div_static #(
    .DIV_VALUE            ( 100  ),
    .ENABLE_CLOCK_IN_RESET( 1'b1 )
  ) i_rt_clk_div (
    .clk_i          ( clk_fll_out[carfield_pkg::RtClockIdx] ),
    .rst_ni         ( pwr_on_rst_n                          ),
    .en_i           ( 1'b1                                  ),
    .test_mode_en_i ( 1'b0                                  ),
    .clk_o          ( domain_clk[carfield_pkg::RtClockIdx]  )
  );

  for (genvar i = 1; i < carfield_pkg::NumFll; i++)
    assign domain_clk[i] = clk_fll_out[i];

  assign fll_pwd          = '{default: 1'b0};
  assign fll_ret          = '{default: 1'b0};
  assign fll_test_mode    = '{default: 1'b0};
  assign fll_scan_e       = '{default: 1'b0};
  assign fll_scan_in      = '{default: 1'b0};
  assign fll_scan_jtag_in = '{default: 1'b0};

  // synchronize power-on rst with ref clock (required by padframe)
  rstgen i_ref_clk_rstgen (
    .clk_i  (ref_clk),
    .rst_ni (pwr_on_rst_n),
    .test_mode_i ( '0 ),
    .rst_no (ref_clk_pwr_on_rst_n),
    .init_no ()
  );

`ifdef GF22_FLL
  fll_wrap #(
    .NUM_FLL        ( carfield_pkg::NumFll ),
    // Addresses are double-word aligned (0x2002_0000, 0x2002_0008, ...)
    .FLL_REG_OFFSET ( 3                    ),
    .reg_req_t      ( carfield_reg_req_t   ),
    .reg_rsp_t      ( carfield_reg_rsp_t   )
  ) i_fll_wrap (
    .clk_ref_i           ( ref_clk                           ),
    .rst_n_i             ( ref_clk_pwr_on_rst_n              ),
    .clk_bypass_i        ( st_pad2soc_signals.ref_clk_i      ),
    .bypass_i            ( st_pad2soc_signals.fll_bypass_i   ),
    .async_req_i         ( ext_reg_async_slv_req_src_out[0]  ),
    .async_ack_o         ( ext_reg_async_slv_ack_src_in[0]   ),
    .async_data_i        ( ext_reg_async_slv_data_src_out[0] ),
    .async_req_o         ( ext_reg_async_slv_req_src_in[0]   ),
    .async_ack_i         ( ext_reg_async_slv_ack_src_out[0]  ),
    .async_data_o        ( ext_reg_async_slv_data_src_in[0]  ),
    .clk_fll_out_o       ( clk_fll_out                       ),
    .clk_fll_e_i         ( clk_fll_e                         ),
    .fll_lock_o          ( fll_lock                          ),
    .fll_pwd_i           ( fll_pwd                           ),
    .fll_ret_i           ( fll_ret                           ),
    .fll_test_mode_i     ( fll_test_mode                     ),
    .fll_scan_e_i        ( fll_scan_e                        ),
    .fll_scan_in_i       ( fll_scan_in                       ),
    .fll_scan_out_o      ( fll_scan_out                      ),
    .fll_scan_jtag_in_i  ( fll_scan_jtag_in                  ),
    .fll_scan_jtag_out_o ( fll_scan_jtag_out                 )
  );
`else
  logic              dummy_rst;
  logic              dummy_clk;
  carfield_reg_rsp_t dummy_rsp;

  clk_rst_gen #(
    .ClkPeriod    ( 20ns ),
    .RstClkCycles ( 33   )
  ) i_dummy_fll (
    .clk_o  ( dummy_clk ),
    .rst_no ( dummy_rst )
  );
  assign clk_fll_out = '{default: dummy_clk & dummy_rst};
  assign fll_lock    = '{default: dummy_rst};

  reg_cdc_dst #(
  .CDC_KIND ( "cdc_4phase"       ),
  .req_t    ( carfield_reg_req_t ),
  .rsp_t    ( carfield_reg_rsp_t )
  ) i_fake_cdc (
    .dst_clk_i    ( dummy_clk                         ),
    .dst_rst_ni   ( dummy_rst                         ),
    .dst_req_o    (                                   ),
    .dst_rsp_i    ( dummy_rsp                         ),

    .async_req_i  ( ext_reg_async_slv_req_src_out[0]  ),
    .async_ack_o  ( ext_reg_async_slv_ack_src_in[0]   ),
    .async_data_i ( ext_reg_async_slv_data_src_out[0] ),

    .async_req_o  ( ext_reg_async_slv_req_src_in[0]   ),
    .async_ack_i  ( ext_reg_async_slv_ack_src_out[0]  ),
    .async_data_o ( ext_reg_async_slv_data_src_in[0]  )
   );
   assign dummy_rsp.ready = 1'b1;
   assign dummy_rsp.error = 1'b0;
   assign dummy_rsp.rdata = 'hCACABABE;
`endif

  // soc2pad
  // clocks
  // verilog_lint: waive-start line-length
  assign st_soc2pad_signals.fll_host_clk_o   = debug_signals.host_clk;
  assign st_soc2pad_signals.fll_secd_clk_o   = debug_signals.domain_clk[CarfieldDomainIdx.secured];
  // verilog_lint: waive-stop line-length

  //////////////////
  // Carfield SoC //
  //////////////////
  wire pad_config_tc_pad_internal_signals_0;
  wire pad_config_tc_pad_internal_signals_1;
  wire pad_config_tc_pad_internal_signals_2;
  wire pad_config_tc_pad_internal_signals_3;

  carfield      #(
    .Cfg         ( Cfg ),
    .reg_req_t   ( carfield_reg_req_t ),
    .reg_rsp_t   ( carfield_reg_rsp_t )
  ) i_dut (
    .domain_clk_i               ( domain_clk[carfield_pkg::NumFll-1:0] ),
    .pwr_on_rst_ni              ( pwr_on_rst_n                         ),
    .test_mode_i                ( '0                                   ),
    .boot_mode_i                ( bootmode_host_s[1:0]                 ),
    .fll_lock_i                 ( fll_lock                             ),
    .jtag_tck_i                 ( st_pad2soc_signals.jtag_tclk_i       ),
    .jtag_trst_ni               ( st_pad2soc_signals.jtag_trst_ni      ),
    .jtag_tms_i                 ( st_pad2soc_signals.jtag_tms_i        ),
    .jtag_tdi_i                 ( st_pad2soc_signals.jtag_tdi_i        ),
    .jtag_tdo_o                 ( st_soc2pad_signals.jtag_tdo_o        ),
    .jtag_tdo_oe_o              (                                      ),
    .jtag_ot_tck_i              ( st_pad2soc_signals.jtag_ot_tclk_i    ),
    .jtag_ot_trst_ni            ( st_pad2soc_signals.jtag_ot_trst_ni   ),
    .jtag_ot_tms_i              ( st_pad2soc_signals.jtag_ot_tms_i     ),
    .jtag_ot_tdi_i              ( st_pad2soc_signals.jtag_ot_tdi_i     ),
    .jtag_ot_tdo_o              ( st_soc2pad_signals.jtag_ot_tdo_o     ),
    .jtag_ot_tdo_oe_o           (                                      ),
    .bootmode_ot_i              ( bootmode_sec_isln_s                  ),
    .jtag_safety_island_tck_i   ( '0                                   ),
    .jtag_safety_island_trst_ni ( '0                                   ),
    .jtag_safety_island_tms_i   ( '0                                   ),
    .jtag_safety_island_tdi_i   ( '0                                   ),
    .jtag_safety_island_tdo_o   (                                      ),
    .bootmode_safe_isln_i       ( bootmode_safe_isln_s                 ),
    .secure_boot_i              ( secure_boot                          ),
    .uart_tx_o                  ( st_soc2pad_signals.uart_tx_o         ),
    .uart_rx_i                  ( st_pad2soc_signals.uart_rx_i         ),
    .uart_ot_tx_o               ( st_soc2pad_signals.ot_uart_tx_o      ),
    .uart_ot_rx_i               ( st_pad2soc_signals.ot_uart_rx_i      ),
    .i2c_sda_o                  (                                      ),
    .i2c_sda_i                  ( '0                                   ),
    .i2c_sda_en_o               (                                      ),
    .i2c_scl_o                  (                                      ),
    .i2c_scl_i                  ( '0                                   ),
    .i2c_scl_en_o               (                                      ),
    .spih_sck_o                 ( spih_sck_o_s                         ),
    .spih_sck_en_o              (                                      ),
    .spih_csb_o                 ( spih_csb_o_s                         ),
    .spih_csb_en_o              (                                      ),
    .spih_sd_o                  ( spih_sd_o_s                          ),
    .spih_sd_en_o               ( spih_sd_en_o_s                       ),
    .spih_sd_i                  ( spih_sd_i_s                          ),
    // spi secd
    .spih_ot_sck_o              ( spih_ot_sck_o_s                      ),
    .spih_ot_sck_en_o           (                                      ),
    .spih_ot_csb_o              ( spih_ot_csb_o_s                      ),
    .spih_ot_csb_en_o           (                                      ),
    .spih_ot_sd_o               ( spih_ot_sd_o_s                       ),
    .spih_ot_sd_en_o            ( spih_ot_sd_en_o_s                    ),
    .spih_ot_sd_i               ( spih_ot_sd_i_s                       ),
    // ethernet
    .eth_rxck_i                 ( '0                                   ),
    .eth_rxctl_i                ( '0                                   ),
    .eth_rxd_i                  ( eth_rxd_i_s                          ),
    .eth_md_i                   ( '0                                   ),
    .eth_txck_o                 (                                      ),
    .eth_txctl_o                (                                      ),
    .eth_txd_o                  (                                      ),
    .eth_md_o                   (                                      ),
    .eth_md_oe                  (                                      ),
    .eth_mdc_o                  (                                      ),
    .eth_rst_n_o                (                                      ),
    // can bus
    .can_rx_i                   ( '0                                   ),
    .can_tx_o                   (                                      ),
    // gpios
    .gpio_i                     ( gpio_in_s                            ),
    .gpio_o                     ( gpio_out_s                           ),
    .gpio_en_o                  ( gpio_tx_en_s                         ),
    // serial link
    .slink_rcv_clk_i            ( '0                                   ),
    .slink_rcv_clk_o            (                                      ),
    .slink_i                    ( serial_link_data_in_s                ),
    .slink_o                    (                                      ),
    // hyperbus
    .pad_config_tc_pad_internal_signals_0(pad_config_tc_pad_internal_signals_0),
    .pad_config_tc_pad_internal_signals_1(pad_config_tc_pad_internal_signals_1),
    .pad_config_tc_pad_internal_signals_2(pad_config_tc_pad_internal_signals_2),
    .pad_config_tc_pad_internal_signals_3(pad_config_tc_pad_internal_signals_3),
    .pad_hyper_phy0_cs_n_0_pad,
    .pad_hyper_phy0_cs_n_1_pad,
    .pad_hyper_phy0_ck_pad,
    .pad_hyper_phy0_ck_n_pad,
    .pad_hyper_phy0_rwds_pad,
    .pad_hyper_phy0_dq_b0_pad,
    .pad_hyper_phy0_dq_b1_pad,
    .pad_hyper_phy0_dq_b2_pad,
    .pad_hyper_phy0_dq_b3_pad,
    .pad_hyper_phy0_dq_b4_pad,
    .pad_hyper_phy0_dq_b5_pad,
    .pad_hyper_phy0_dq_b6_pad,
    .pad_hyper_phy0_dq_b7_pad,
    .pad_hyper_phy0_reset_n_pad,
    .pad_hyper_phy1_cs_n_0_pad,
    .pad_hyper_phy1_cs_n_1_pad,
    .pad_hyper_phy1_ck_pad,
    .pad_hyper_phy1_ck_n_pad,
    .pad_hyper_phy1_rwds_pad,
    .pad_hyper_phy1_dq_b0_pad,
    .pad_hyper_phy1_dq_b1_pad,
    .pad_hyper_phy1_dq_b2_pad,
    .pad_hyper_phy1_dq_b3_pad,
    .pad_hyper_phy1_dq_b4_pad,
    .pad_hyper_phy1_dq_b5_pad,
    .pad_hyper_phy1_dq_b6_pad,
    .pad_hyper_phy1_dq_b7_pad,
    .pad_hyper_phy1_reset_n_pad,
    .ext_reg_async_slv_req_o    ( ext_reg_async_slv_req_src_out  ),
    .ext_reg_async_slv_ack_i    ( ext_reg_async_slv_ack_src_in   ),
    .ext_reg_async_slv_data_o   ( ext_reg_async_slv_data_src_out ),
    .ext_reg_async_slv_req_i    ( ext_reg_async_slv_req_src_in   ),
    .ext_reg_async_slv_ack_o    ( ext_reg_async_slv_ack_src_out  ),
    .ext_reg_async_slv_data_i   ( ext_reg_async_slv_data_src_in  ),
    // Debug Signals
    .debug_signals_o            ( debug_signals                  )
  );

  //////////////
  // Padframe //
  //////////////

  //TODO: TO ASK is ref_clk the correct clock for pads?

  reg_cdc_dst #(
     .CDC_KIND ( "cdc_4phase"       ),
     .req_t    ( carfield_reg_req_t ),
     .rsp_t    ( carfield_reg_rsp_t )
  ) i_reg_cdc_dst_padframe (
      .dst_clk_i   ( ref_clk                           ),
      .dst_rst_ni  ( ref_clk_pwr_on_rst_n              ),
      .dst_req_o   ( padframe_refclk_cfg_reg_req       ),
      .dst_rsp_i   ( padframe_refclk_cfg_reg_rsp       ),

      .async_req_i ( ext_reg_async_slv_req_src_out[1]  ),
      .async_ack_o ( ext_reg_async_slv_ack_src_in[1]   ),
      .async_data_i( ext_reg_async_slv_data_src_out[1] ),

      .async_req_o ( ext_reg_async_slv_req_src_in[1]   ),
      .async_ack_i ( ext_reg_async_slv_ack_src_out[1]  ),
      .async_data_o( ext_reg_async_slv_data_src_in[1]  )
  );

  top_padframe_wrapper #(
    .req_t  ( carfield_reg_req_t ),
    .resp_t ( carfield_reg_rsp_t )
  ) i_top_padframe_wrapper (
    .clk_i           ( ref_clk              ),
    .rst_ni          ( ref_clk_pwr_on_rst_n ),
    .signals_pad2soc ( st_pad2soc_signals   ),
    .signals_soc2pad ( st_soc2pad_signals   ),
    // Landing Pads
    .pad_botl_config_tc_pad_internal_signals_0 (pad_config_tc_pad_internal_signals_0),
    .pad_botl_config_tc_pad_internal_signals_1 (pad_config_tc_pad_internal_signals_1),
    .pad_botl_config_tc_pad_internal_signals_2 (pad_config_tc_pad_internal_signals_2),
    .pad_botl_config_tc_pad_internal_signals_3 (pad_config_tc_pad_internal_signals_3),
    .pad_botl_ot_boot_mode_pad,
    .pad_botl_jtag_ot_tclk_pad,
    .pad_botl_jtag_ot_trst_n_pad,
    .pad_botl_jtag_ot_tms_pad,
    .pad_botl_jtag_ot_tdi_pad,
    .pad_botl_jtag_ot_tdo_pad,
    .pad_botl_ot_uart_tx_pad,
    .pad_botl_ot_uart_rx_pad,
    .pad_botl_spih_sck_pad,
    .pad_botl_spih_csb_pad,
    .pad_botl_spih_sd_0_pad,
    .pad_botl_spih_sd_1_pad,
    .pad_botl_spih_sd_2_pad,
    .pad_botl_spih_sd_3_pad,
    .pad_botl_gpio_2_pad,
    .pad_botl_gpio_3_pad,
    .pad_botl_spih_ot_sd_1_pad,
    .pad_botl_spih_ot_sd_2_pad,
    .pad_botl_spih_ot_sd_3_pad,
    .pad_botl_ref_clk_pad,
    .pad_botl_fll_host_pad,
    .pad_botl_fll_secd_pad,
    .pad_botl_fll_bypass_pad,
    .pad_botl_pwr_on_rst_n_pad,
    .pad_botl_boot_mode_0_pad,
    .pad_botl_boot_mode_1_pad,
    .pad_botl_secure_boot_pad,
    .pad_botl_jtag_tclk_pad,
    .pad_botl_jtag_trst_n_pad,
    .pad_botl_jtag_tms_pad,
    .pad_botl_jtag_tdi_pad,
    .pad_botl_jtag_tdo_pad,
    .pad_botl_uart_tx_pad,
    .pad_botl_uart_rx_pad,
    .pad_botl_gpio_0_pad,
    .pad_botl_gpio_1_pad,
    .pad_botl_spih_ot_sck_pad,
    .pad_botl_spih_ot_csb_pad,
    .pad_botl_spih_ot_sd_0_pad,
    // Config Interface
    .config_req_i ( padframe_refclk_cfg_reg_req ),
    .config_rsp_o ( padframe_refclk_cfg_reg_rsp )
  );

endmodule: astral_wrap
