FondazioneChipsIT/astral/(commit log)

2025-02-03 Remove Thales IPs from default flow to be used on non-iis environment
    * Remove them from bender manifest as they are still not benderized
    * Add Make target to copy IPs from specific iis directory if needed
    * Change Astral default configuration
2025-09-20 Fix SDF parsing errors and UART print in simulation.
2025-09-20 Fix number of APB master ports
    [carfield_pkg.sv]
2025-09-20 Fix L2 addresses in memory map.
    [addressability_test.c, car_memory_map.h]
2026-01-18 Embed UART initialization into `car_init_start` function.
2026-01-18 Switch to Questa One simulation flow
2026-01-18 Add `carfield_pkg::` references where missing.
    [carfield.sv]
2026-01-18 Use package parameters for HyperBus avoiding top-level propagation.
    [astral_wrap.sv, carfield.sv, carfield_pkg.sv]
2026-01-18 Add GF22 design flow.
2026-01-18 Fix AXI isolate parametrization
    [carfield.sv]
2026-01-18 Add rule to generate dma code
2026-01-18 Update timer unit
2026-01-20 Draft tech sim flow
2026-01-20 Split QSIM and VSIM flows
2026-01-27 Fix and generate new padframe
    [astral_wrap.sv, carfield_secure_periph.sv]
2026-01-30 [REGMAP] Fix default values for clk_en, clk_sel and axi isolate for secd
    [carfield_regs.csv]
2026-02-05 [REGMAP] Restore security island default config with axi_isolate=1 and clk_en=0
    [carfield_regs.csv]
2026-02-16 [SW] Add Secure Domain tests compilation flow (WIP)
2026-02-18 [SW] Enable printing from Security Island on host UART
2026-02-21 [SW] Fix Secure Domain tests compilation flow
2026-02-23 Integrate new HyperBus and padframe
    [hyperbus_padframe.csv]
2026-02-23 Fix simulation and cleanup
    [addressability_test.c, astral_wrap.sv, car_memory_map.h]
2026-02-27 Add trigger and watermark interrupts to security island (#31)
2026-03-03 Top-level padframe integration (#26)
    * Fix and generate new padframe
    * Fix south pads orientation
    * Fix iogen script
    * Add configurable drive strength to top padframe
    * Complete integration with hyperbus padframe
    * Remove unused files
    [astral_padframe.csv, padring.csv]
2026-03-13 Add dividers for external debug clocks
    [carfield_regs.csv]
2026-03-17 Fixes for top PnR
    [astral_padframe.csv]
2026-04-02 Update tc_pad modules to fix issue in post-synth sim
    [scarv_config.yml]
2026-04-03 [BUMP] Bump security island
    * Add register files for SECD
    * Add internal clock dividers for cluster and OT and remove
    clk_cluster_i port from top module
    * Avoid SSH clone for gitmodules
    [carfield.sv]
2026-04-07 [hyperbus][HW] Removed corner pad in RTL
    Corner PAD(s) removed from RTL to better manage them in PnR
    Padrick files aligned to this change.
    Padrick template changed to remove import of unused package
    Removed unused padrick csv file
    update gitignore
    [hyperbus_padframe.csv]
2026-04-22 [SW] Improve SECD SW compile flow
    * Move to Bazel for OpenTitan tests
    * Rewrite secd sw makefrag; targets are no more the build directories,
    incremental compile should work again
    * Adapt and extend CI
2026-04-22 sw: mbox_test now using chs plic library + printf wrapped in LOG
2026-04-24 [SW][BUMP] Snooper stress test: simplify to single dummy region and bump OT
    - Simplify snooper_stress_test.c to use a single dummy code region
    (dummy3) testing recirculation and halt, removing dummy1/dummy2 logic
    - Replace manual snooper register helpers with scratch-register-based
    CVA6<->ibex synchronization protocol
    - Bump OpenTitan to pr/snooper-stress-test branch
    (ec68699991adc33446f54581fba541f692c26de6)
    - Update secd sw.mk accordingly
    [snooper_stress_test.c]
2026-05-14 [DOC] Review PCR regmap
    [skip ci]
    [carfield_regs.csv]
2026-06-18 Revert "Move PULP Cluster config into package."
    This reverts commit ad107c9fa12369e37460925c1f4e7dd7f198c836.
    [carfield.sv, carfield_pkg.sv]
2026-06-18 Minor fix in hw/carfield.sv to account for the revert commit 4cc6a78
    [carfield.sv]
2026-06-18 fpga: Add vcu118 vanilla flow and Xilinx IPs to enable fpga synthesis on vcu118
2026-06-18 flavour_vanilla: replaced output probe 2 of the VIO core with boot_mode_security, which is set to zero by default.
2026-06-18 FPGA: If no auxiliary jtag connection is added (GEN_AUX_JTAG), the host and secure domain are connected in a daisy chain.
2026-06-18 [FPGA] Add support for block design vivado project targeting the vcu118 board
2026-06-18 [FPGA] Update the flavour bd flow: hyperbus and aux jtag are now supported.
2026-06-18 [FPGA] Minor fix to simplify flavour vanilla flow
2026-06-19 FIX: netlist printf work
    [carfield.sv, helloworld.c]
